Lina-500/Base-Mobile-/Supports piliers/supports poutres.SLDASM

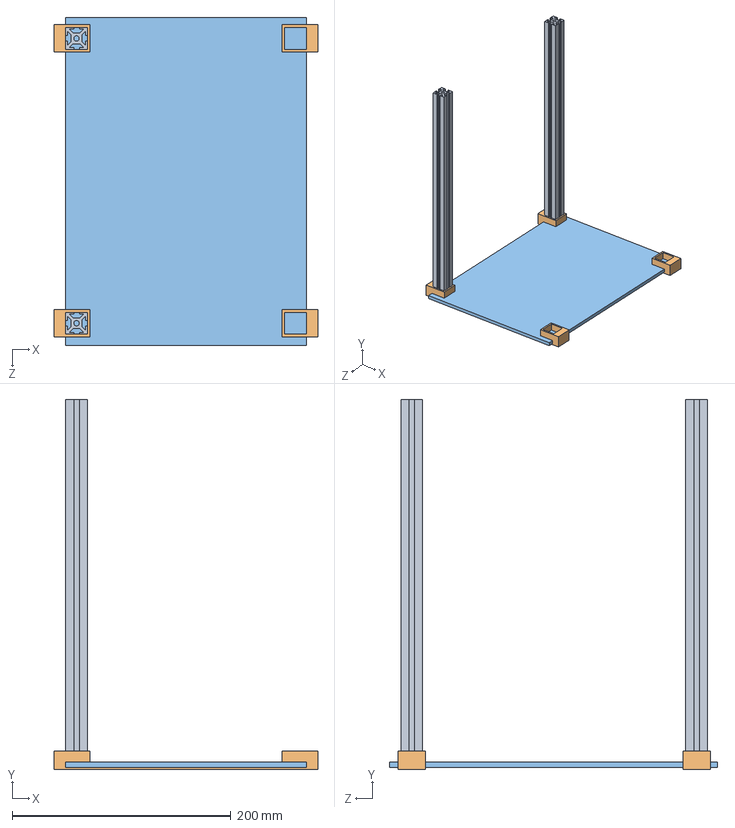
[picture p22: CAD file, 2026-10-25]
Supports piliers/supports poutres.SLDASM
241.0 x 338.0 x 300.0 mm
EXEMPLE
support poutres x 2
poteau x 2
