Lina-500/Base-Mobile-/Pieces SW/roue+moteur.SLDASM

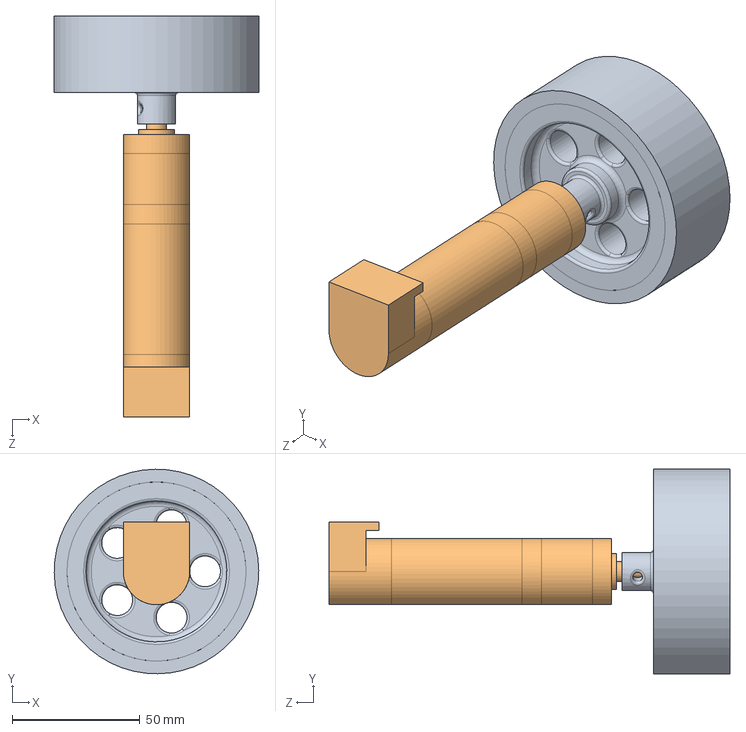
[picture p23: CAD file, 2026-10-25]
Pieces SW/roue+moteur.SLDASM
80.0 x 80.0 x 156.8 mm
moteur
la roues princ
