Lina-500/Base-Mobile-/Pieces SW/BASE MOBILE.SLDASM

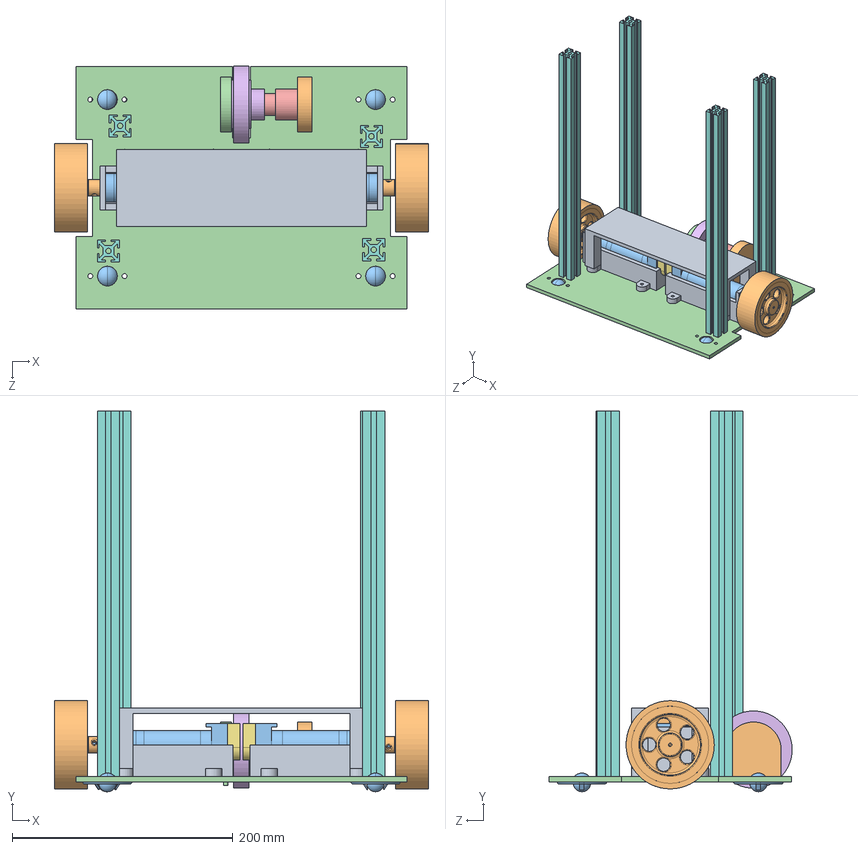
[picture p24: CAD file, 2026-10-25]
Pieces SW/BASE MOBILE.SLDASM
339.0 x 344.9 x 220.6 mm
Base
moteur x 2
la roues princ x 2
supportmoteur x 2
poteau x 4
coquille de l'encodeur moteur x 2
Roue codeuse
support de la roue codeuse
support roue libre droit
roue folle x 4
Support moteur de la roue codeuse
tables pour pompes
