Lina-500/Base-Mobile-/Pieces SW/Roue codeuse.SLDPRT

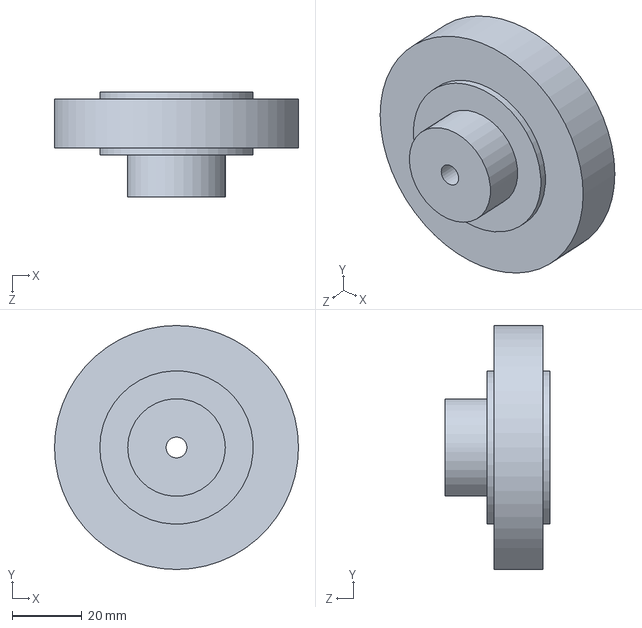
[picture p25: CAD file, 2026-10-25]
Pieces SW/Roue codeuse.SLDPRT
70.0 x 70.0 x 30.0 mm
