Lina-500/Base-Mobile-/Supports piliers/EXEMPLE.SLDPRT

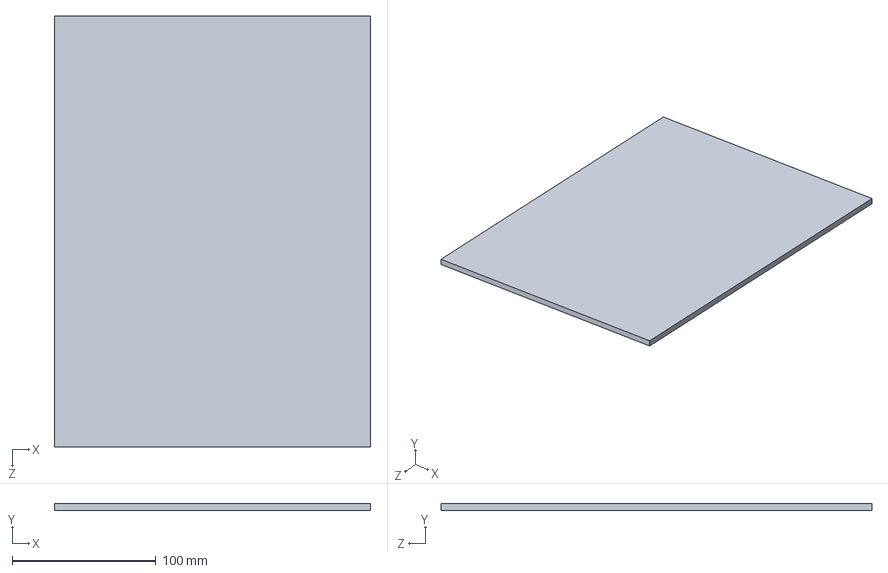
[picture p26: CAD file, 2026-10-25]
Supports piliers/EXEMPLE.SLDPRT
220.0 x 5.00 x 300.0 mm
