Lina-500/Base-Mobile-/Pieces SW/roue folle.SLDPRT

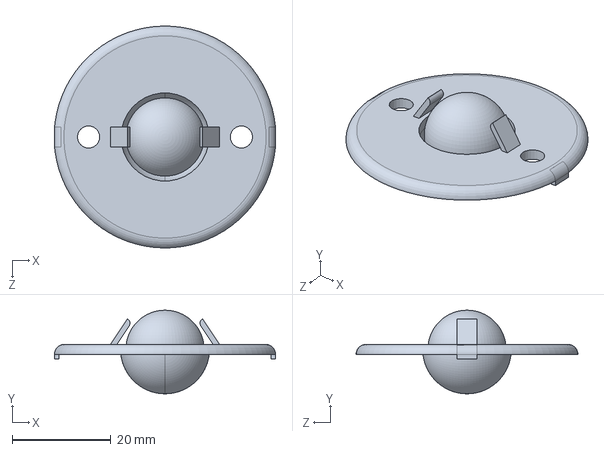
[picture p27: CAD file, 2026-10-25]
Pieces SW/roue folle.SLDPRT
44.8 x 17.0 x 45.0 mm
