Lina-500/Base-Mobile-/Supports piliers/support poutres.SLDPRT

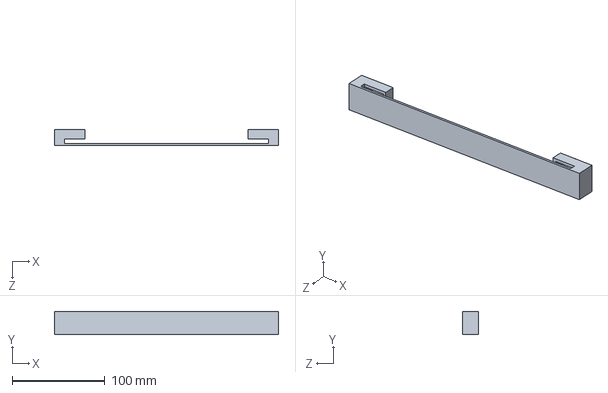
[picture p28: CAD file, 2026-10-25]
Supports piliers/support poutres.SLDPRT
241.0 x 25.0 x 17.0 mm
