Lina-500/Base-Mobile-/Pieces SW/Base.SLDPRT

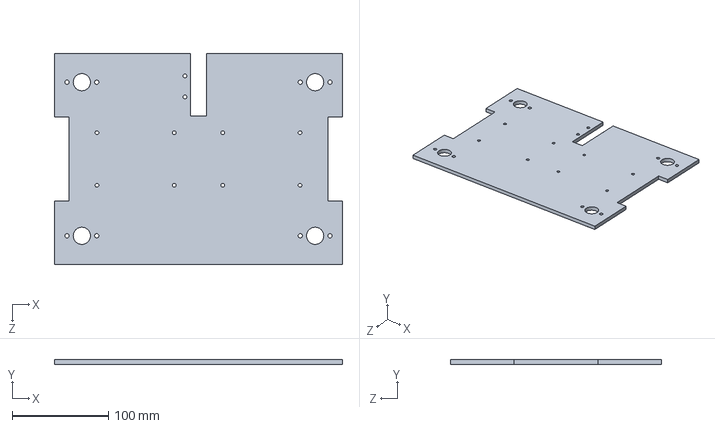
[picture p29: CAD file, 2026-10-25]
Pieces SW/Base.SLDPRT
300.0 x 5.00 x 220.0 mm
