Lina-500/Base-Mobile-/Pieces SW/la roues princ.SLDPRT

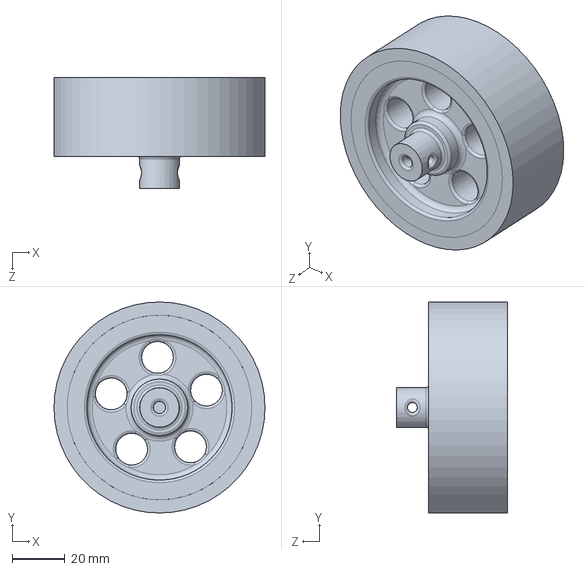
[picture p30: CAD file, 2026-10-25]
Pieces SW/la roues princ.SLDPRT
80.0 x 80.0 x 42.2 mm
