Lina-500/Base-Mobile-/Pieces SW/moteur.SLDPRT

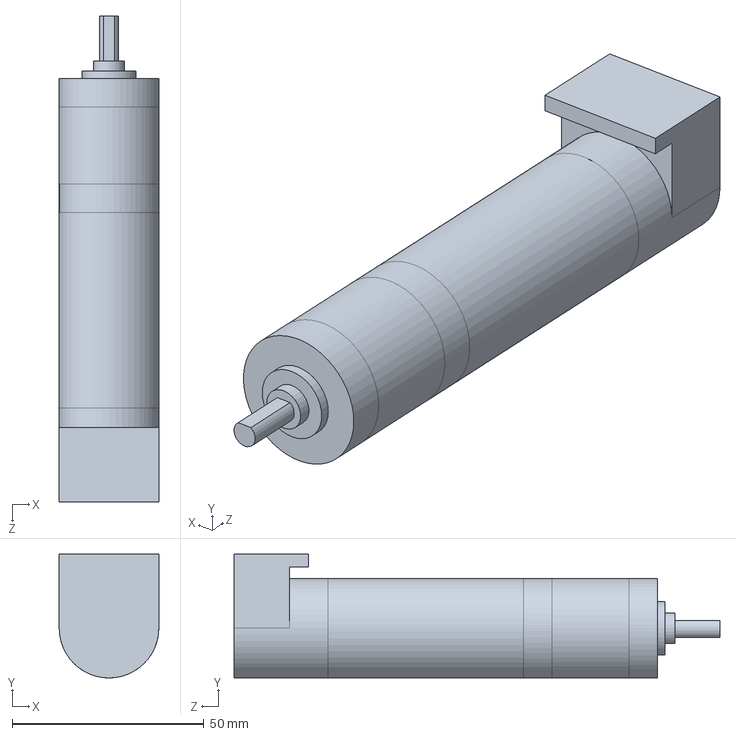
[picture p31: CAD file, 2026-10-25]
Pieces SW/moteur.SLDPRT
26.0 x 32.3 x 126.8 mm
