Lina-500/Base-Mobile-/Pieces SW/support de la roue codeuse.SLDPRT

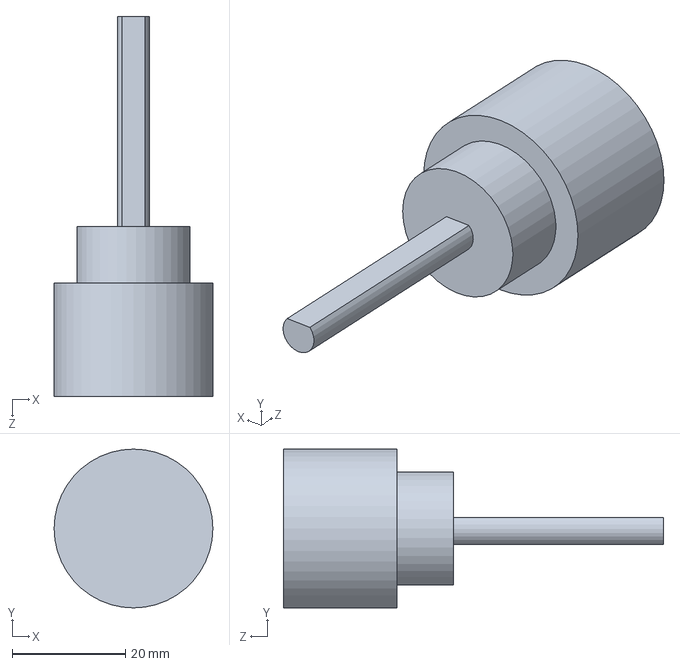
[picture p32: CAD file, 2026-10-25]
Pieces SW/support de la roue codeuse.SLDPRT
28.0 x 28.0 x 67.0 mm
