Lina-500/Base-Mobile-/Pieces SW/poteau.SLDPRT

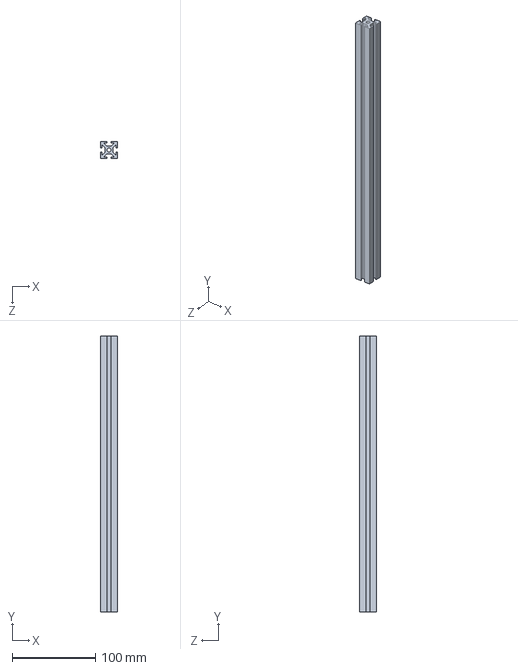
[picture p33: CAD file, 2026-10-25]
Pieces SW/poteau.SLDPRT
20.0 x 331.0 x 20.0 mm
