Lina-500/Base-Mobile-/Pieces SW/supportmoteur.SLDPRT

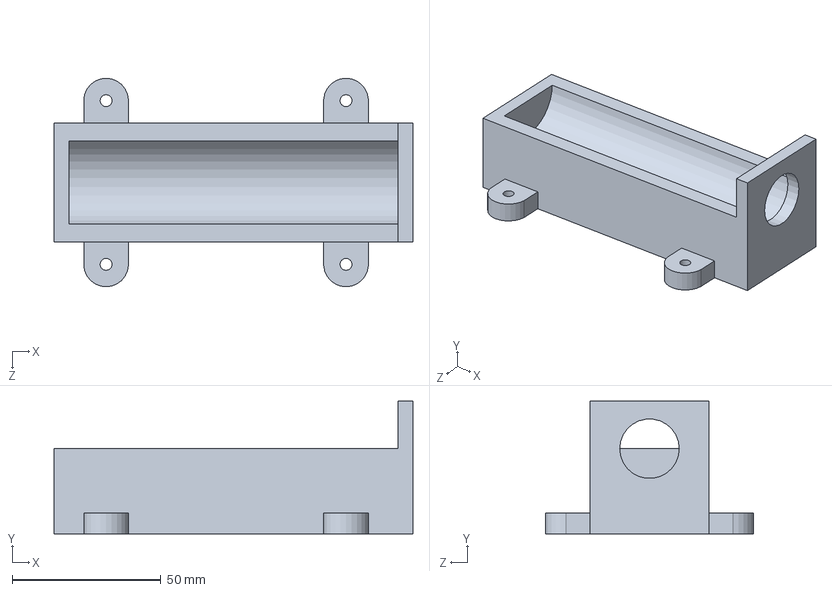
[picture p34: CAD file, 2026-10-25]
Pieces SW/supportmoteur.SLDPRT
120.6 x 44.7 x 70.0 mm
