Lina-500/Base-Mobile-/Pieces SW/support roue libre droit.SLDPRT

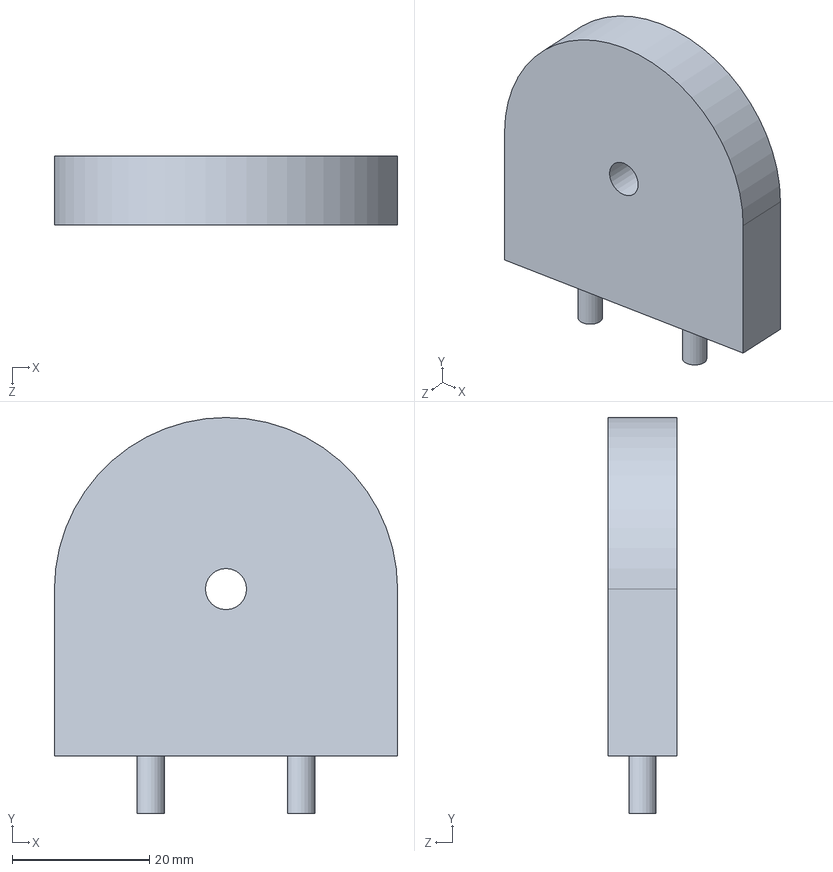
[picture p35: CAD file, 2026-10-25]
Pieces SW/support roue libre droit.SLDPRT
50.0 x 57.7 x 10.0 mm
