Lina-500/Base-Mobile-/Pieces SW/Support moteur de la roue codeuse.SLDPRT

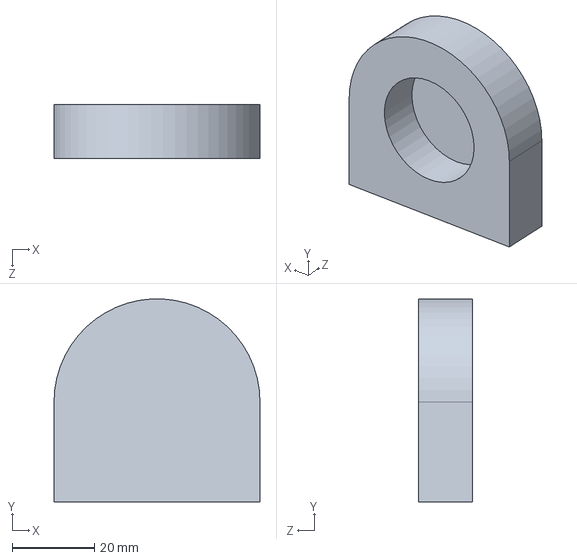
[picture p36: CAD file, 2026-10-25]
Pieces SW/Support moteur de la roue codeuse.SLDPRT
50.0 x 49.3 x 13.0 mm
