Lina-500/Base-Mobile-/Pieces SW/tables pour pompes.SLDPRT

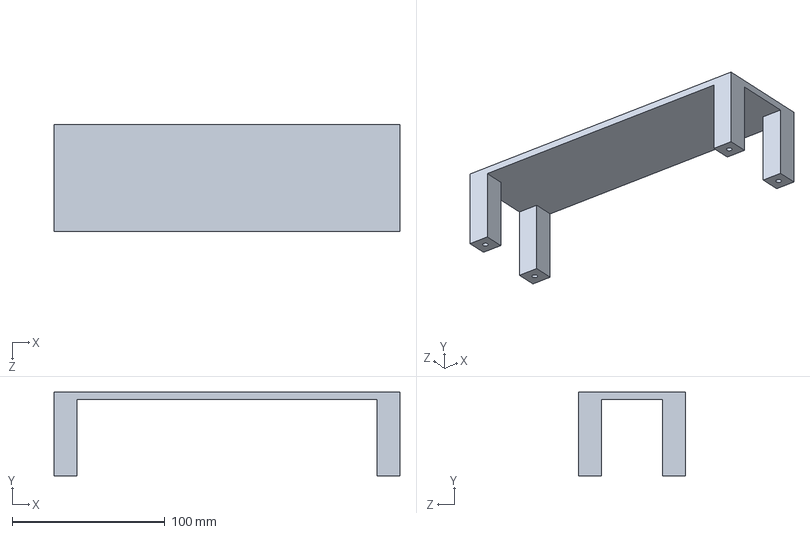
[picture p37: CAD file, 2026-10-25]
Pieces SW/tables pour pompes.SLDPRT
226.6 x 55.0 x 69.9 mm
