Lina-500/Base-Mobile-/Pieces SW/coquille de l'encodeur moteur.SLDPRT

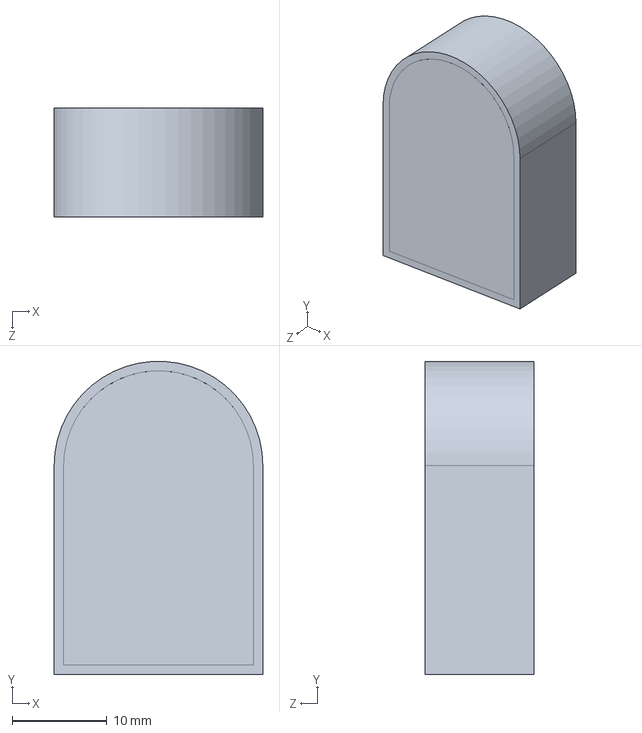
[picture p38: CAD file, 2026-10-25]
Pieces SW/coquille de l'encodeur moteur.SLDPRT
22.0 x 33.0 x 11.5 mm
