Lina-500/Base-Mobile-/Pieces SW/moteur support.SLDASM

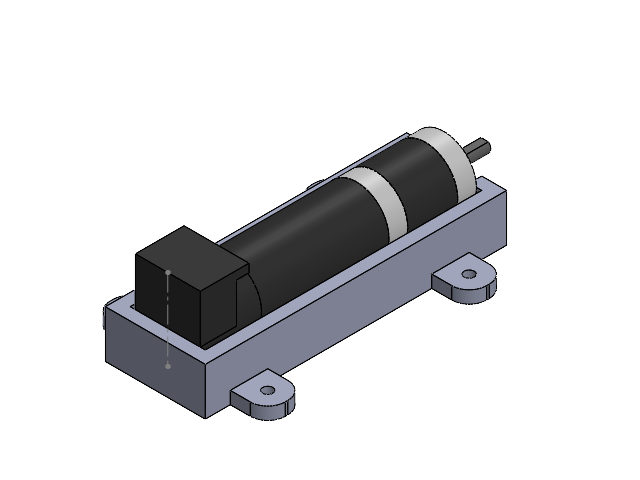
[picture p39: CAD file, 2026-10-25]
Pieces SW/moteur support.SLDASM
moteur
fixation moteur
