Lina-500/Base-Mobile-/(list of files, cad)

Other CAD files:
Pieces SW/composants internes de l'encodeur moteur.SLDPRT
